mar87649/Peristaltic-Pump/README.md

# Peristaltic-Pump

Description:
Peristaltic pump system that draws fluid from multiple containers and mixes the liquid into a microfluidic device.

Status: Development has stopped.
