mar87649/Peristaltic-Pump/Schematic_pump-system_Sheet-1_20190510002939.pdf

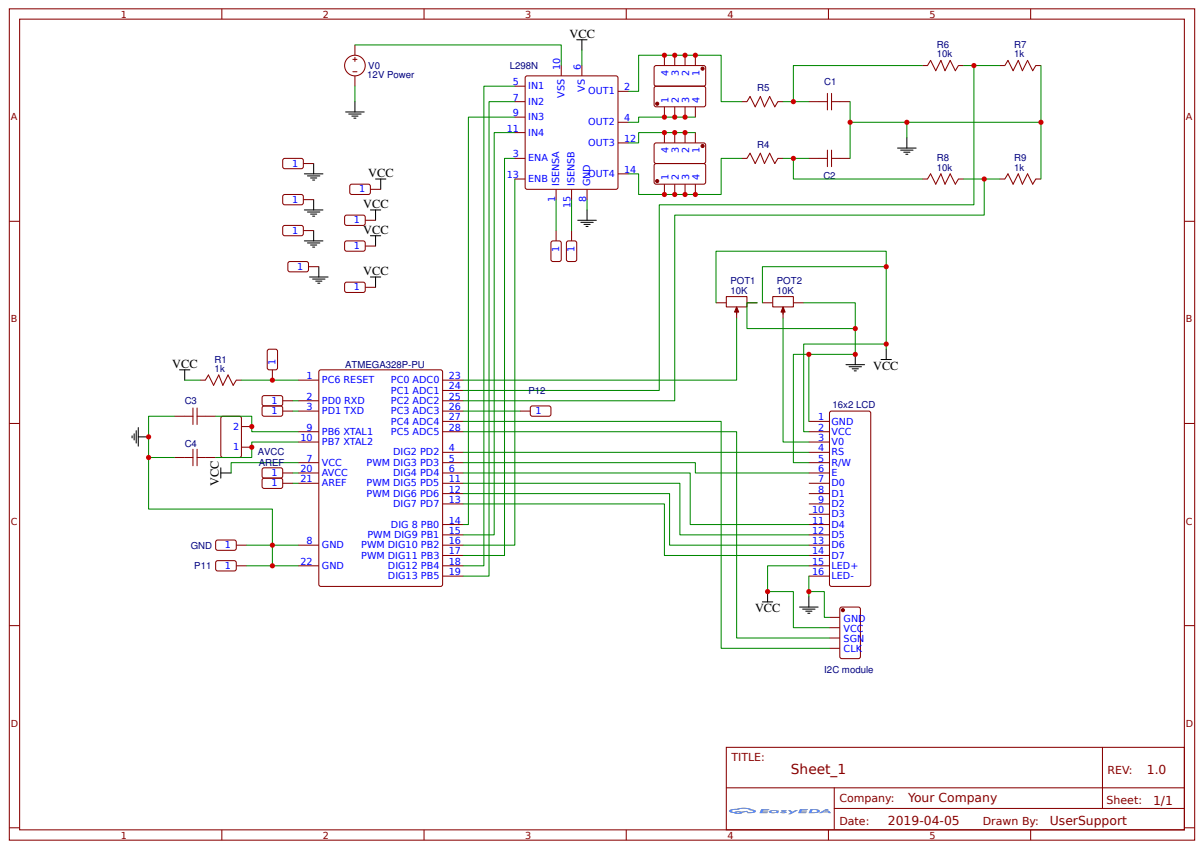
[picture p20: page 1]
