mar87649/Peristaltic-Pump/PCB_pump-system-PCB_20190510002922.pdf

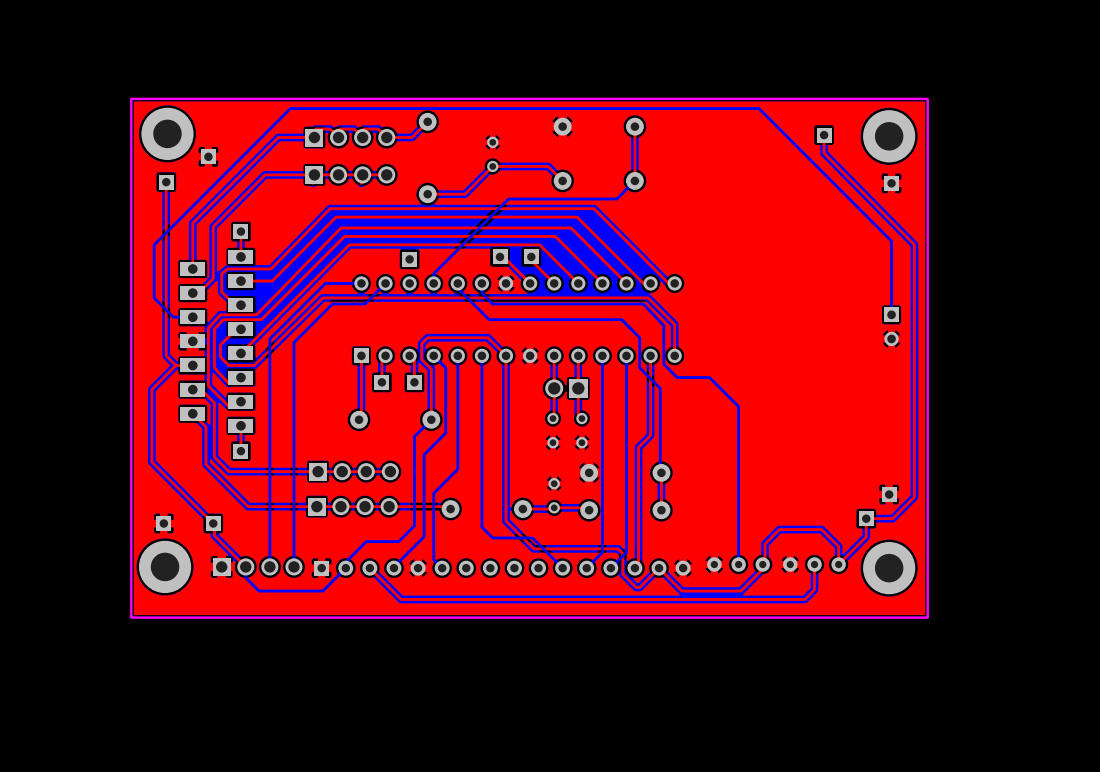
[picture p21: page 1]
